igorlab/ph-leakage-tester/photos/README.md

# Photographs

Photographs of the tester, the amplifier boards and the test set-ups. All files are stored
without EXIF metadata (no GPS, camera model or date).

The photo figures of the paper (cropped, rotated and numbered) are made from these files by
`../figures/make_photo_figures.py`; the numbered parts are explained in the figure captions of
`../paper/HX_paper.md`.

| File | Content |
|---|---|
| `calibrator_outside.jpg` | The tester from outside, with the amplifier board in its holder |
| `calibrator_inside.jpg` | The tester without the display: ESP32-C3 SuperMini, ADS1115, 50 MΩ chain, push button, polarity switch, JP1, 10 kΩ trimmer, J2 and the BNC cable |
| `calibrator_inside_old.jpg` | Earlier internal layout (superseded by `calibrator_inside.jpg`) |
| `calibrator_50M.jpg` | The 50 MΩ series resistor: five 10 MΩ SMD resistors end to end, standing clear of the board |
| `calibrator_vs_ph150.jpg` | Channel A of the tester (−155.0 mV) next to a pH-150MI meter (−155 mV) on the same simulator, 25 °C |
| `board_input.jpg` | Amplifier board, input stage: pin 5 of U1 bent up and wired in the air to the BNC centre, solder links in place of the RA1/RA2 trimmers |
| `board_a_bottom.png` | Amplifier board A, underside, before the REF3040 rework |
| `board_a_ref3040_rework.png` | Board A after the rework: REF3040 on the R5 pads, 47 kΩ and the RA2 link |
| `board_ref3040.png` | REF3040 rework, close-up |
| `boards_three.jpg` | The tester with the amplifier board, a second amplifier board and a PH-4502C module |
| `setup.jpg`, `bench_webpage.jpg` | Bench set-up with the tester and its web page |
| `setup_electrode.jpg`, `setup_electrode_2.jpg` | Buffer test (protocol F): electrode in the 6.86 buffer, board on the tester, 4.00 and 9.18 buffers |
| `electrode_danoplus.jpg` | Box of the DANOPLUS electrode (pH 0–14, 0–60 °C) used as the reference electrode |
| `buffer_sachet.jpg` | Buffer sachet: 250 ml, ±0.01 pH, pH-versus-temperature table |
| `ph4502c_*.jpg` | PH-4502C module, both sides, chip markings |
