igorlab/ph-leakage-tester/figures/fig_known_currents.pdf

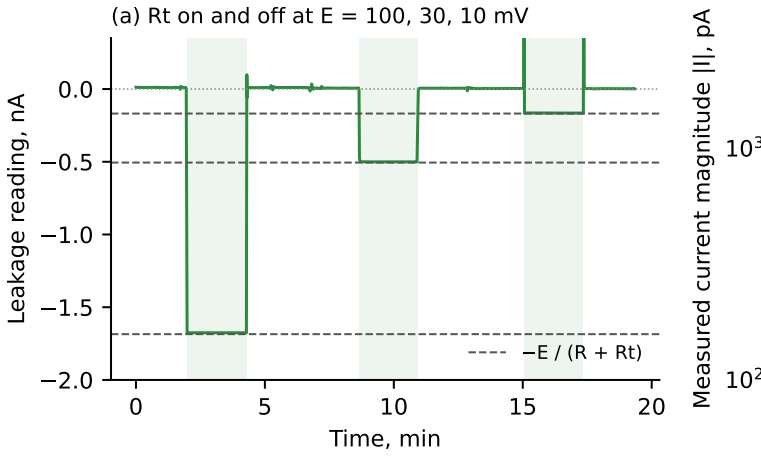
[picture p24: figure]
Time, min; Leakage reading, nA; (a) Rt on and off at E = 100, 30, 10 mV; Measured current magnitude |I|, pA

(b) Measured against expected

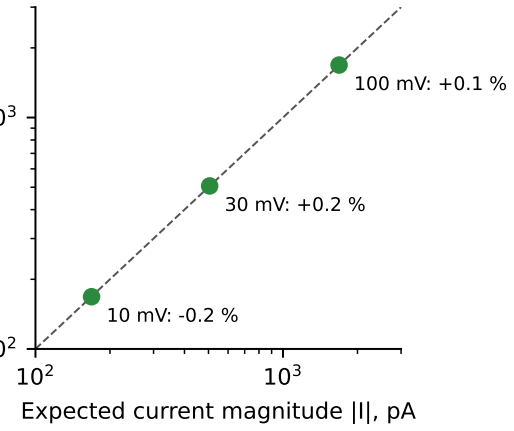
[picture p25: figure]
Expected current magnitude |I|, pA
