igorlab/ph-leakage-tester/figures/graphical_abstract.pdf

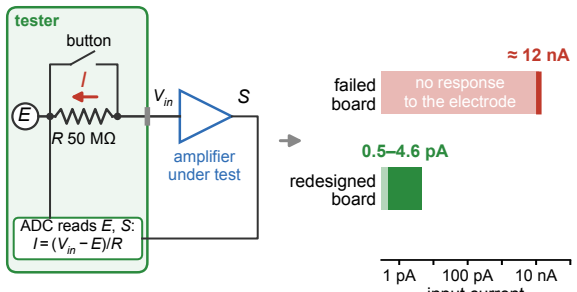
[picture p26: figure]
tester; button; Vin; amplifier under test; ADC reads E, S: I = (Vin; failed board; redesigned board; no response to the electrode
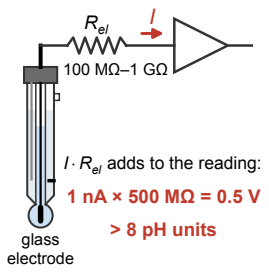
[picture p27: figure]
glass electrode; Rel; I ¢ Rel; adds to the reading:; > 8 pH units

input current

Problem | Tester (≈ EUR 15)

measures I in circuit, through the amplifier's own output

### Application: KH titrator

the redesigned board
runs in the titrator
