igorlab/ph-leakage-tester/figures/fig_principle.pdf

push button

# Button pressed (R shorted):

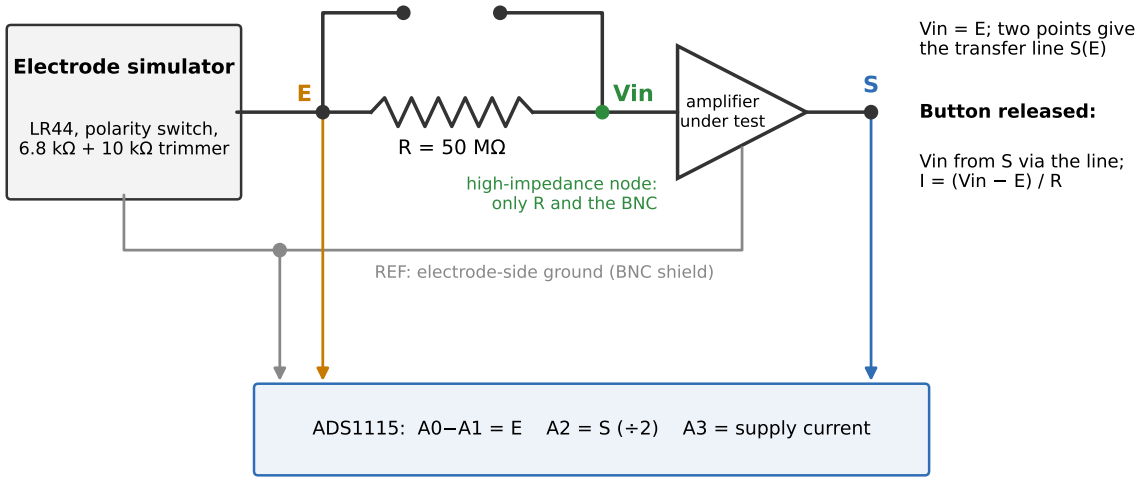
[picture p28: figure]
Electrode simulator; LR44, polarity switch,; k trimmer; Vin; high-impedance node: only R and the BNC; amplifier under test; REF: electrode-side ground (BNC shield); ADS1115: A0 A1 = E; A3 = supply current; Vin = E; two points give the transfer line S(E); Button released:; Vin from S via the line;; I = (Vin
