igorlab/ph-leakage-tester/figures/graphical_abstract.tif

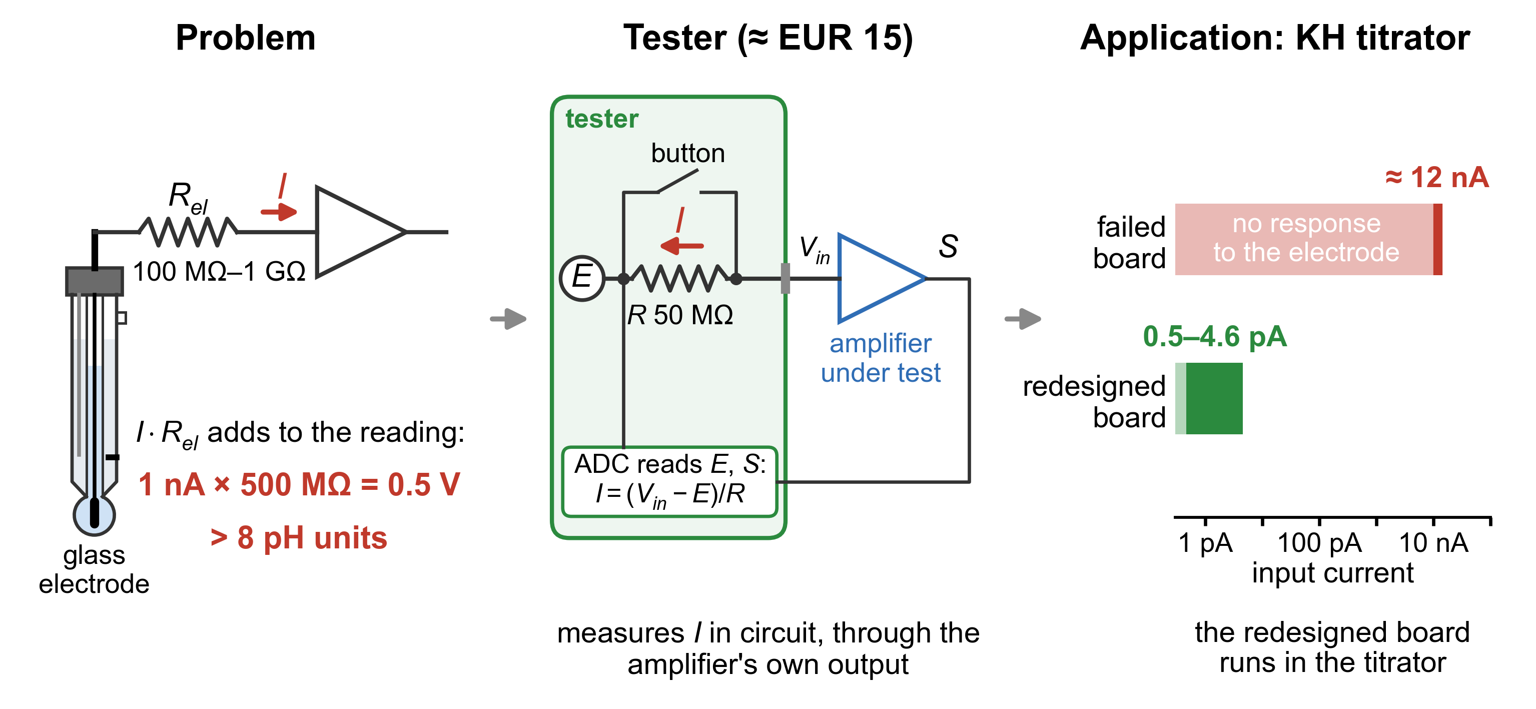
figures/graphical_abstract.tif
