igorlab/ph-leakage-tester/figures/photo_boards.jpg

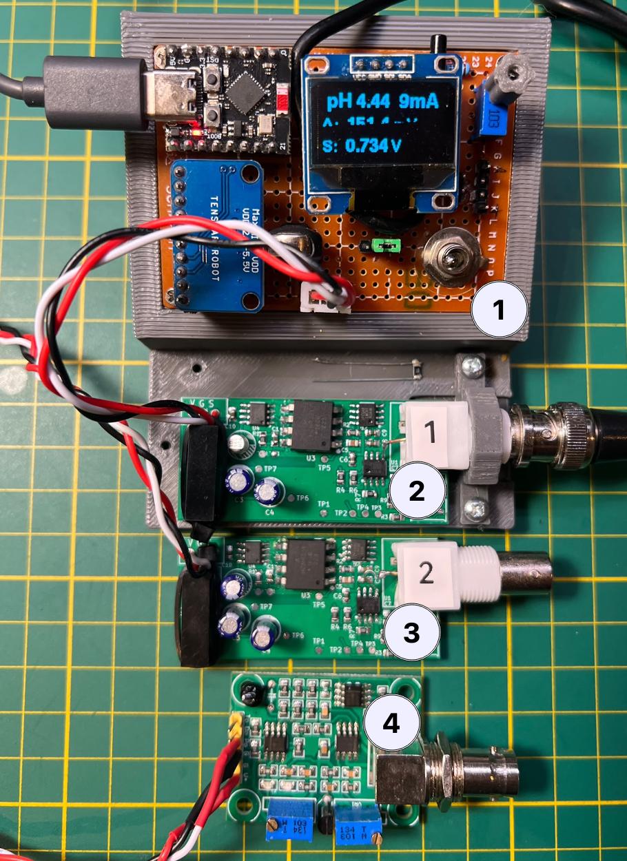
figures/photo_boards.jpg
