igorlab/ph-leakage-tester/figures/photo_channel_a.jpg

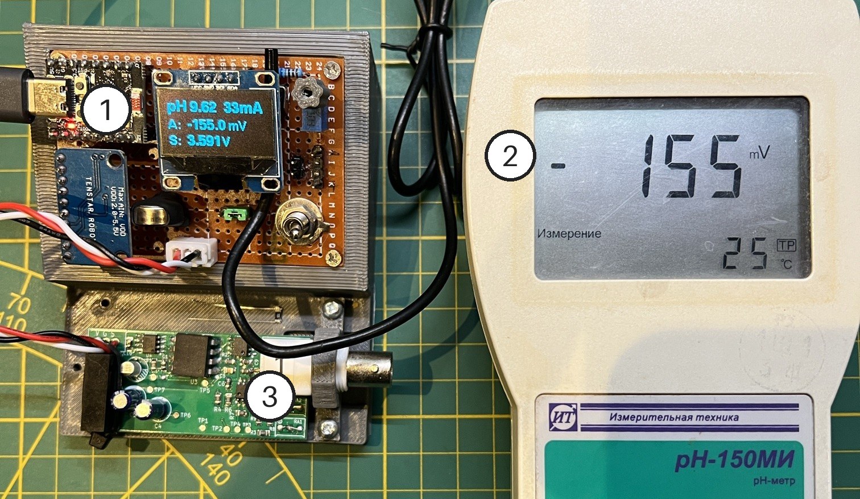
figures/photo_channel_a.jpg
