igorlab/ph-leakage-tester/figures/photo_r50m.jpg

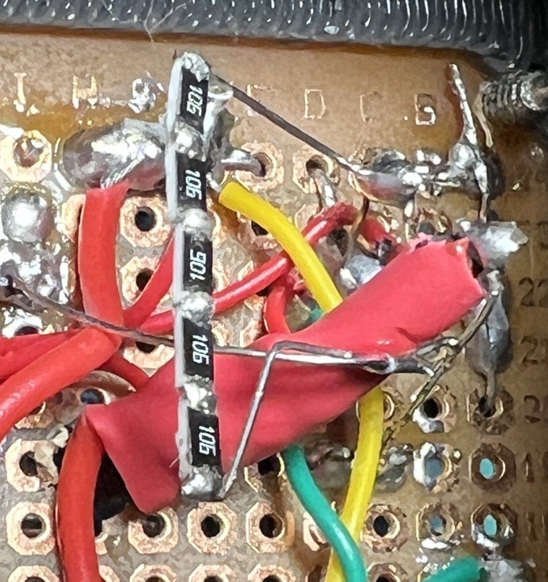
figures/photo_r50m.jpg
