igorlab/ph-leakage-tester/photos/bench_webpage.jpg

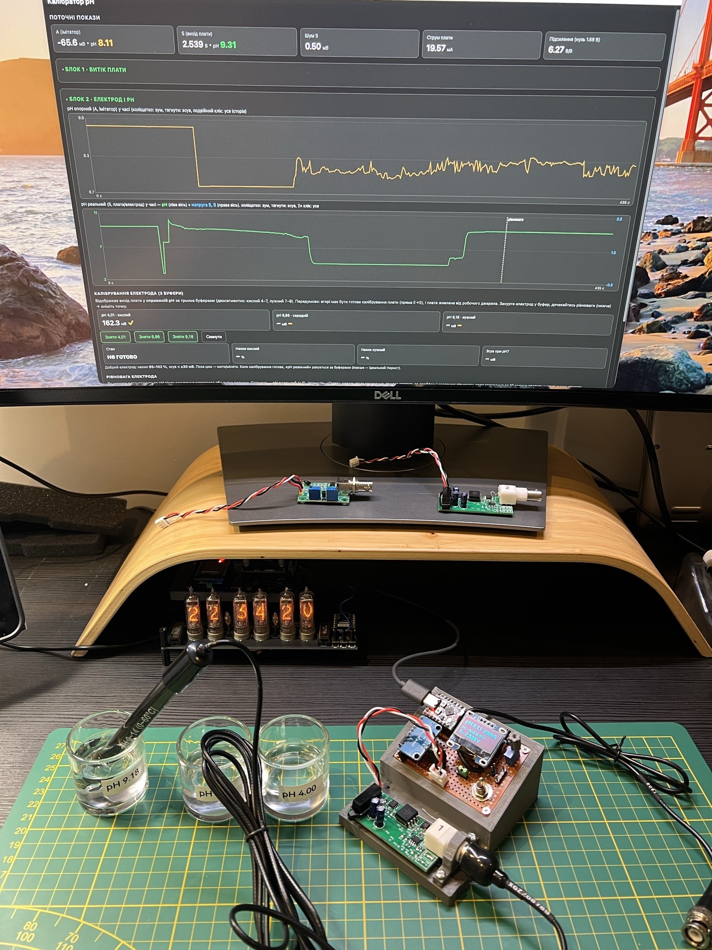
photos/bench_webpage.jpg
