igorlab/ph-leakage-tester/photos/board_a_bottom.png

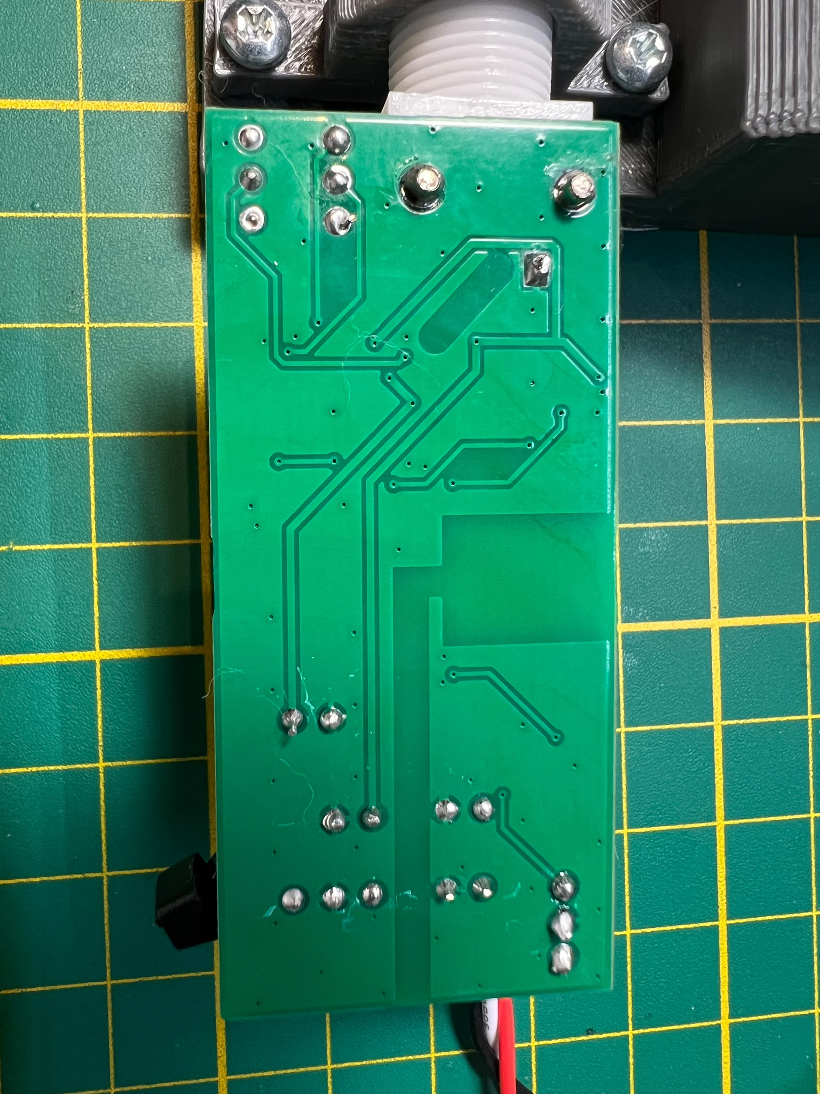
photos/board_a_bottom.png
