igorlab/ph-leakage-tester/photos/board_a_ref3040_rework.png

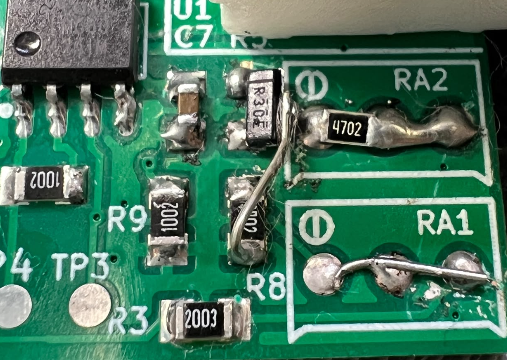
photos/board_a_ref3040_rework.png
