igorlab/ph-leakage-tester/photos/board_input.jpg

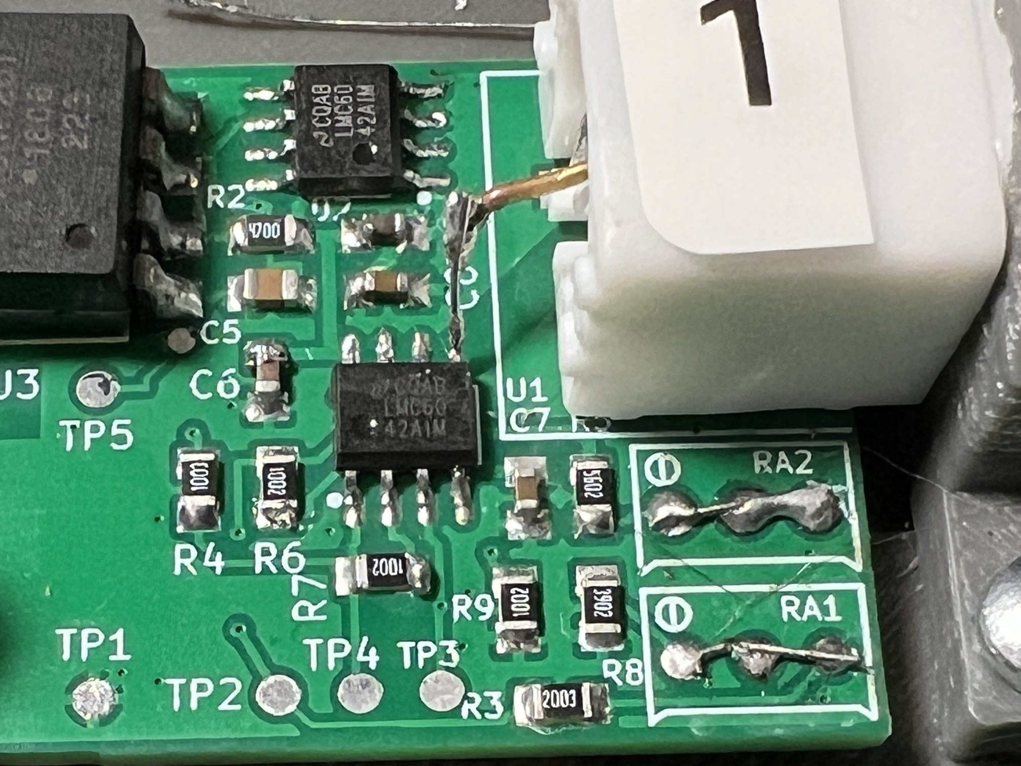
photos/board_input.jpg
