igorlab/ph-leakage-tester/photos/board_ref3040.png

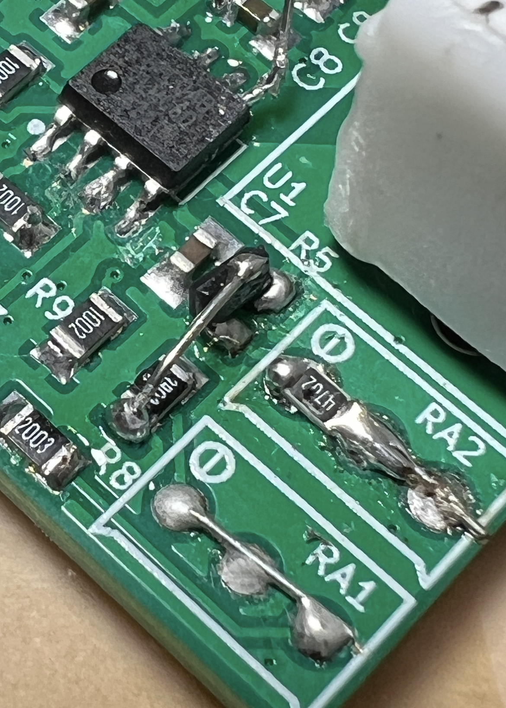
photos/board_ref3040.png
