igorlab/ph-leakage-tester/photos/boards_three.jpg

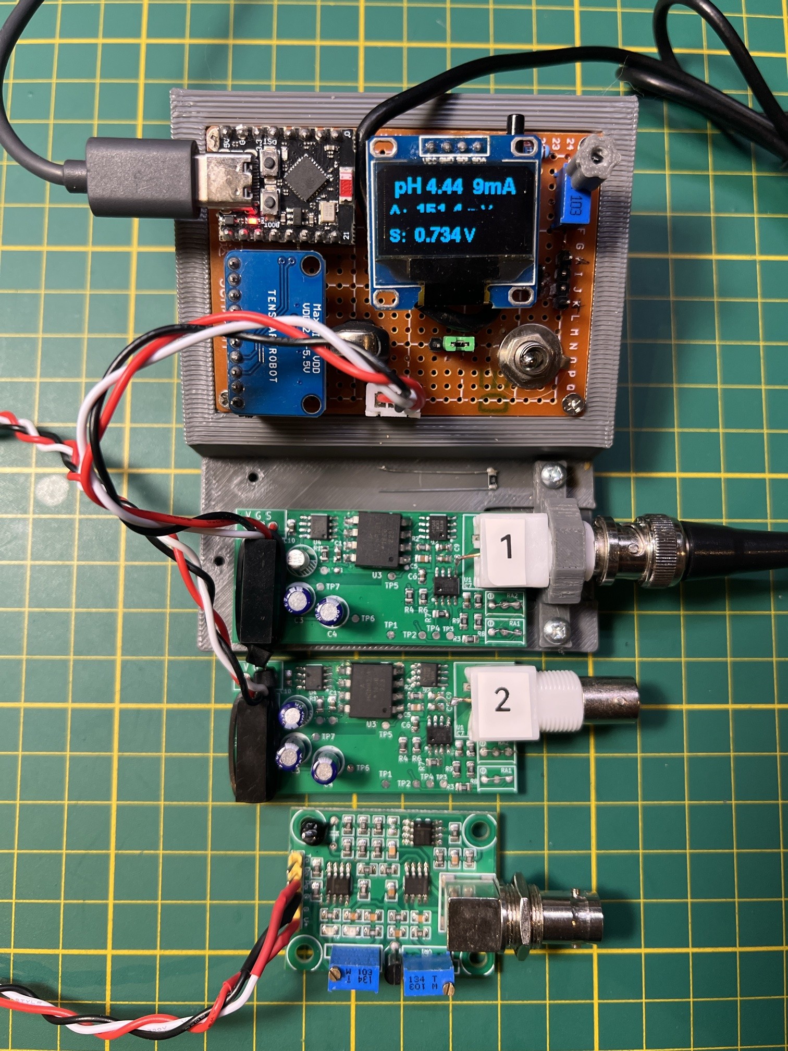
photos/boards_three.jpg
