igorlab/ph-leakage-tester/photos/buffer_sachet.jpg

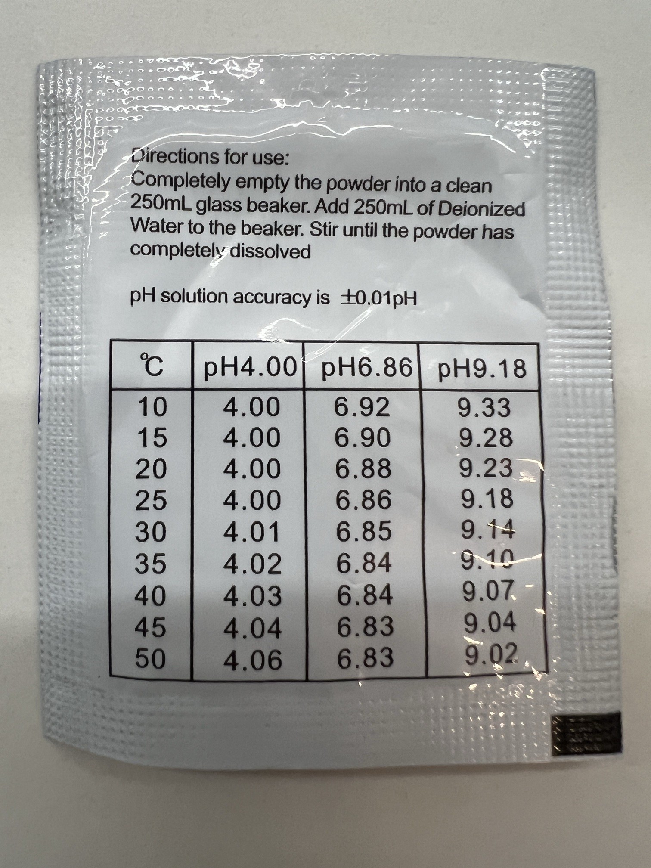
photos/buffer_sachet.jpg
