igorlab/ph-leakage-tester/photos/electrode_danoplus.jpg

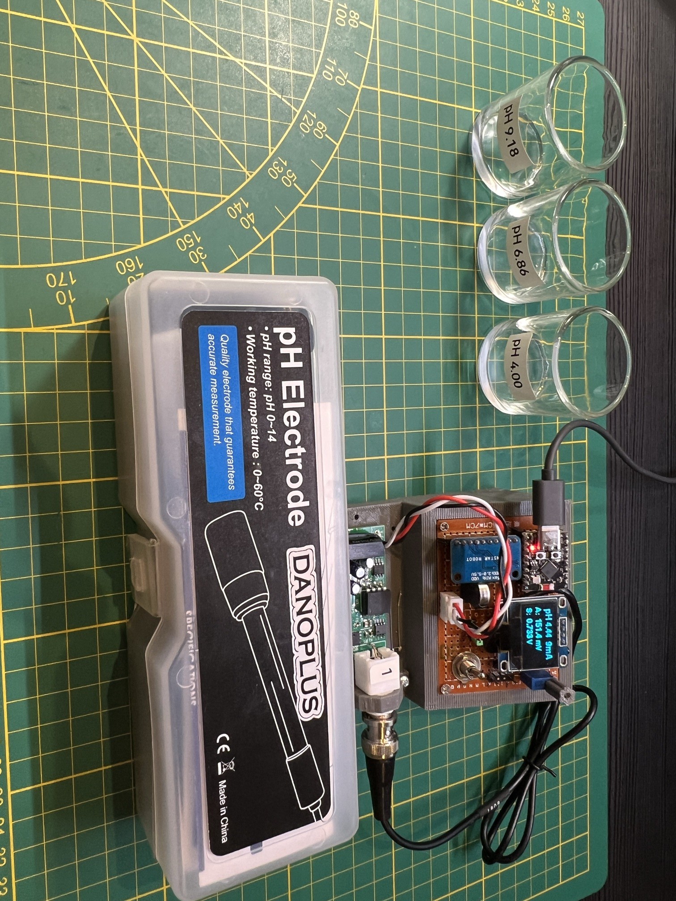
photos/electrode_danoplus.jpg
