igorlab/ph-leakage-tester/photos/ph4502c_back.jpg

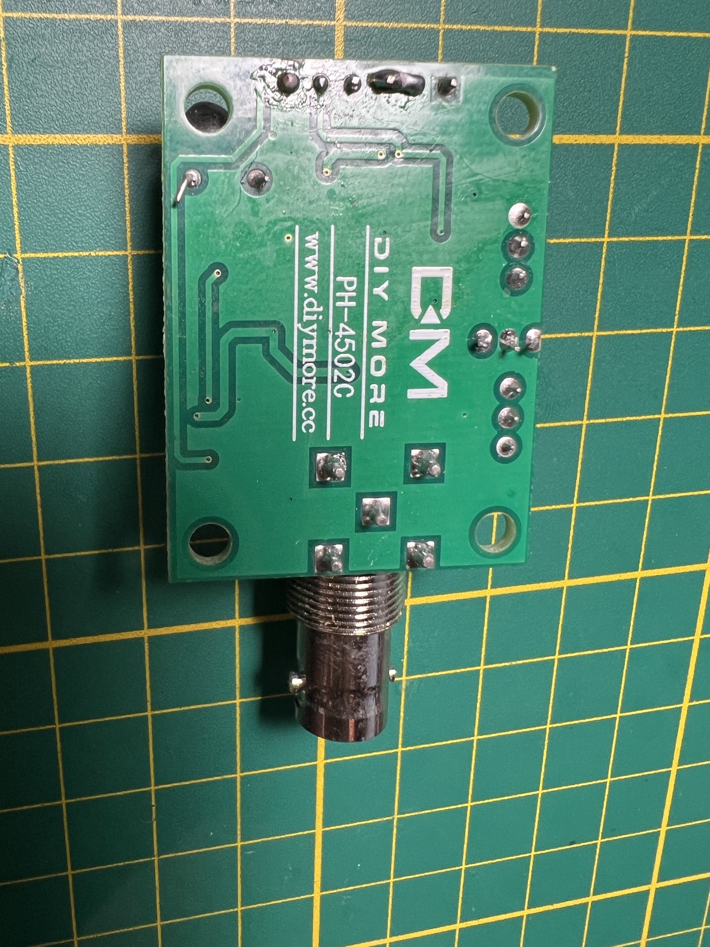
photos/ph4502c_back.jpg
