igorlab/ph-leakage-tester/photos/ph4502c_chips_1.jpg

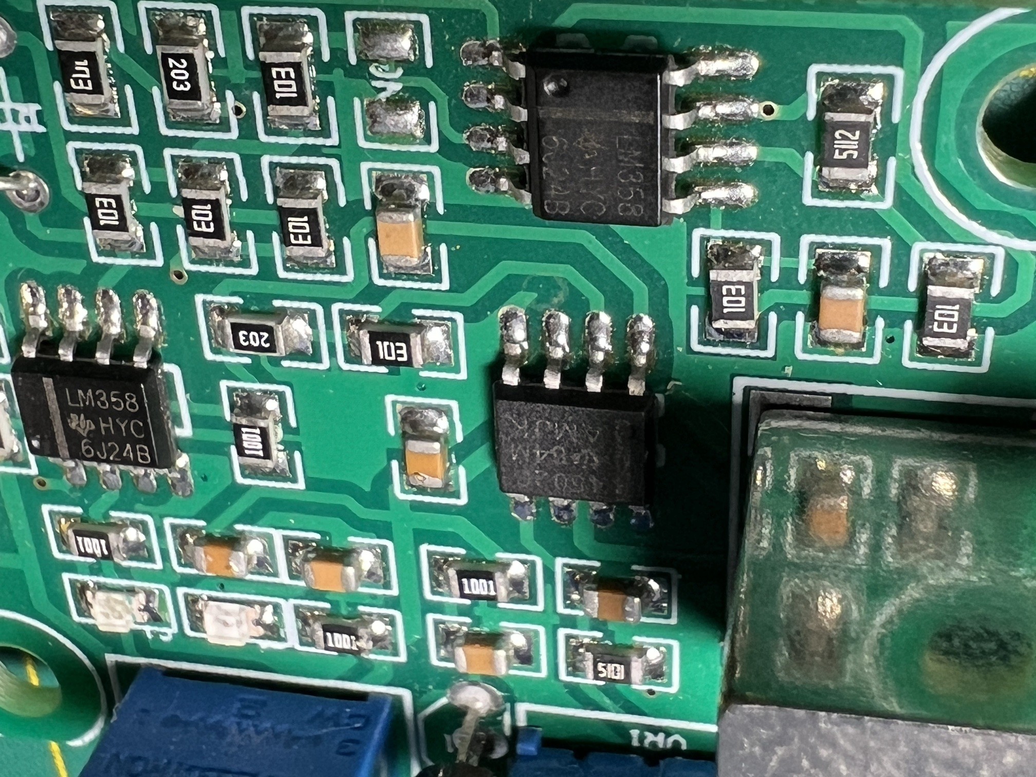
photos/ph4502c_chips_1.jpg
