igorlab/ph-leakage-tester/photos/ph4502c_chips_2.jpg

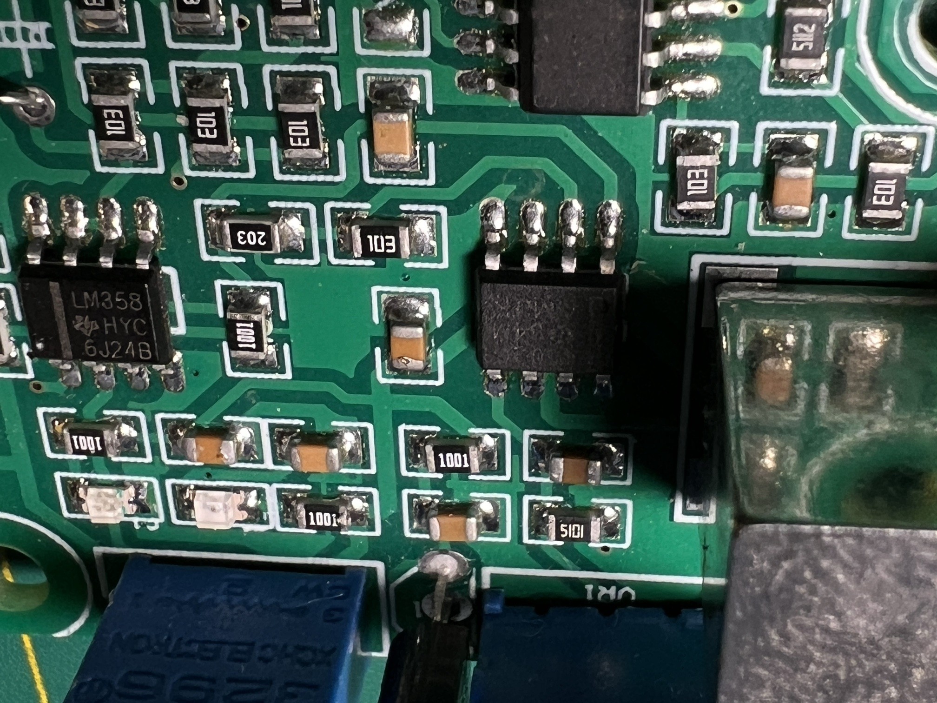
photos/ph4502c_chips_2.jpg
