igorlab/ph-leakage-tester/photos/ph4502c_chips_angle.jpg

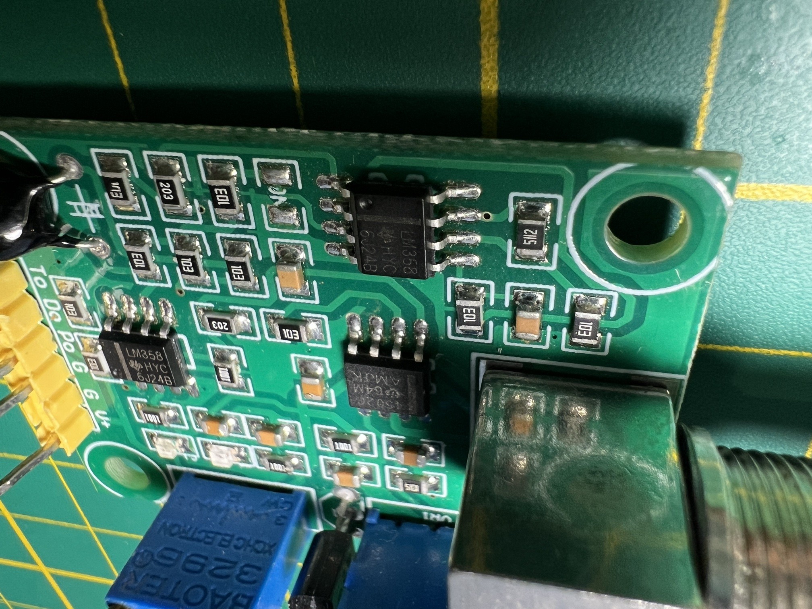
photos/ph4502c_chips_angle.jpg
