igorlab/ph-leakage-tester/photos/ph4502c_top.jpg

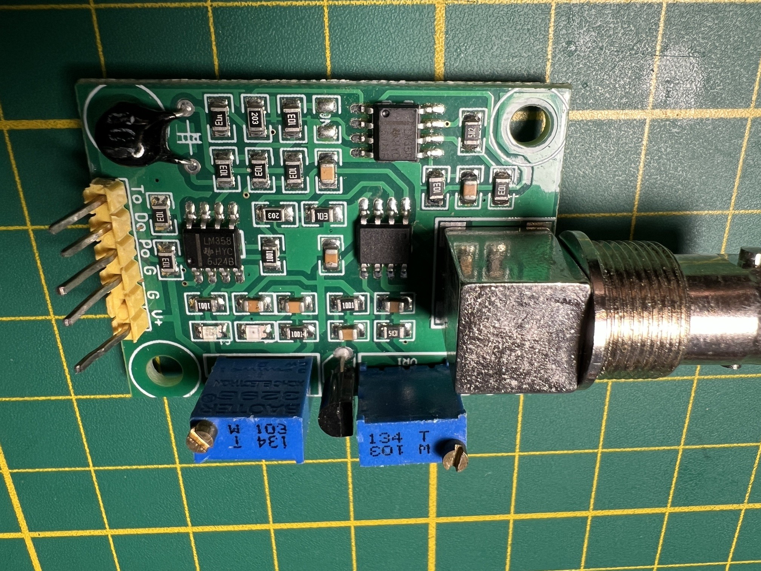
photos/ph4502c_top.jpg
