igorlab/ph-leakage-tester/hardware/calibrator_bom.xlsx

Battery-powered pH calibrator — bill of materials
Yellow cells require operator input. Electrical values and references are taken from hardware/calibrator.kicad_sch (revision 1).
Item | Subsystem | Reference | Quantity | Value | Description | Package / model | Manufacturer part | Supplier | Unit cost (EUR) | Notes / status
1 | Controller | U1 | 1 | ESP32-C3 SuperMini | Microcontroller module | ESP32-C3 SuperMini |  |  |  | Verify exact board version
2 | Measurement | U2 | 1 | ADS1115 module | 16-bit ADC module | ADS1115 breakout |  |  |  | Verify module manufacturer
3 | Display | U3 | 1 | SSD1306 OLED 128×64 | 0.96-inch I²C OLED module |  |  |  |  | Record pin order printed on module
4 | Simulator | BT1 | 1 | LR44 | Battery cell | LR44
5 | Simulator | — | 1 | LR44 holder | Battery holder |  |  |  |  | Not represented separately in schematic
6 | Simulator | SW1 | 1 | ON-OFF-ON | DPDT polarity-reversal switch |  |  |  |  | Centre-off
7 | Simulator | SW2 | 1 | Push button | Momentary button shorting the series resistor |  |  |  |  | Normally open
8 | Simulator | R1 | 1 | 6.8 kΩ | Resistor |  |  |  |  | Tolerance and power rating to confirm
9 | Simulator | RV1 | 1 | 10 kΩ | Trim potentiometer setting simulator voltage E
10 | High-impedance path | R2 | 5 | 10 MΩ | Series resistor chain; 50 MΩ total | 1206 |  |  |  | Five resistors soldered end to end
11 | Output | J1 | 1 | BNC female | Coaxial connector to amplifier input |  |  |  |  | Verify exact connector
12 | Amplifier interface | J2 | 1 | JST 3-pin | Supply, ground and S connection to amplifier |  |  |  |  | Verify JST series and pitch
13 | Amplifier supply | JP1 | 1 | 5 V / 3.3 V | Three-pin supply-selection jumper |  |  |  |  | Include shunt cap
14 | Output measurement | R3 | 1 | 10 kΩ | Resistor |  |  |  |  | Tolerance to confirm
15 | Output measurement | R4 | 1 | 10 kΩ | Resistor |  |  |  |  | Tolerance to confirm
16 | Current measurement | R5 | 1 | 10 Ω | Low-side current-sense shunt |  |  |  |  | Tolerance and power rating to confirm
17 | USB measurement | R6 | 1 | 10 kΩ | USB-voltage divider resistor |  |  |  |  | Orientation and ADC connection must match final schematic
18 | USB measurement | R7 | 1 | 15 kΩ | USB-voltage divider resistor |  |  |  |  | Orientation and ADC connection must match final schematic
19 | Test points | TP1 | 1 | REF | Reference-voltage test point | Pin / header
20 | Test points | TP2 | 1 | E | Simulator-voltage test point | Pin / header
21 | Test points | TP3 | 1 | VIN | Amplifier-input test point | Pin / header
22 | Construction | — | 1 | Perfboard | Main construction board |  |  |  |  | Enter board dimensions
23 | Construction | — |  | Hook-up wire | Point-to-point wiring |  |  |  |  | Enter length or package quantity
24 | Cable | — | 1 | Three-wire cable | Calibrator-to-amplifier cable |  |  |  |  | Record length and connector at amplifier end
25 | Mechanical | — | 1 | 3D-printed enclosure | Calibrator enclosure |  |  |  |  | Record material and print mass/time
26 | Mechanical | — |  | Fasteners and spacers | Mounting hardware |  |  |  |  | Enter quantities and sizes
 |  |  |  |  |  |  |  | Total (EUR) | €0.00
