igorlab/ph-leakage-tester/hardware/enclosure/pH-tester.STEP

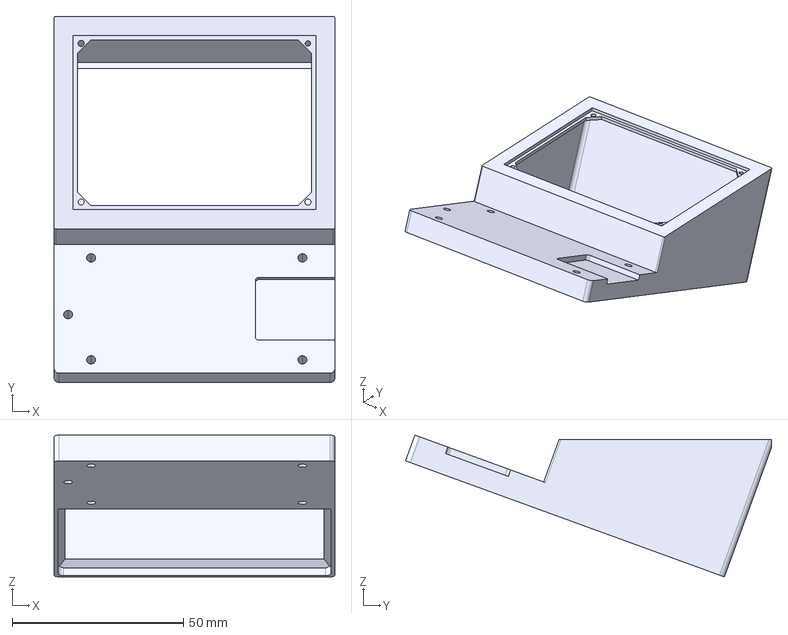
[picture p46: CAD file, 2026-11-10]
hardware/enclosure/pH-tester.STEP
82.0 x 106.8 x 41.4 mm
