igorlab/ph-leakage-tester/hardware/enclosure/board_holder.STEP

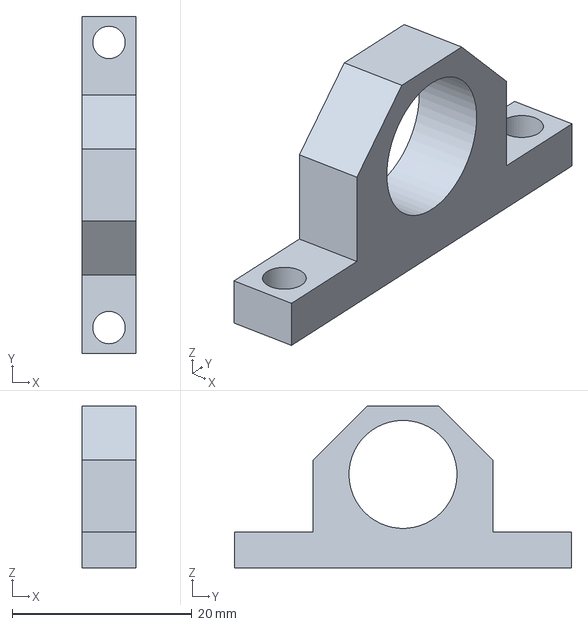
[picture p47: CAD file, 2026-11-10]
hardware/enclosure/board_holder.STEP
6.00 x 37.5 x 18.0 mm
