igorlab/ph-leakage-tester/(list of files, cad)

Other CAD files:
hardware/enclosure/board_holder.STL
hardware/enclosure/pH-tester.STL
