igorlab/ph-leakage-tester/figures/photo_setup_f.jpg

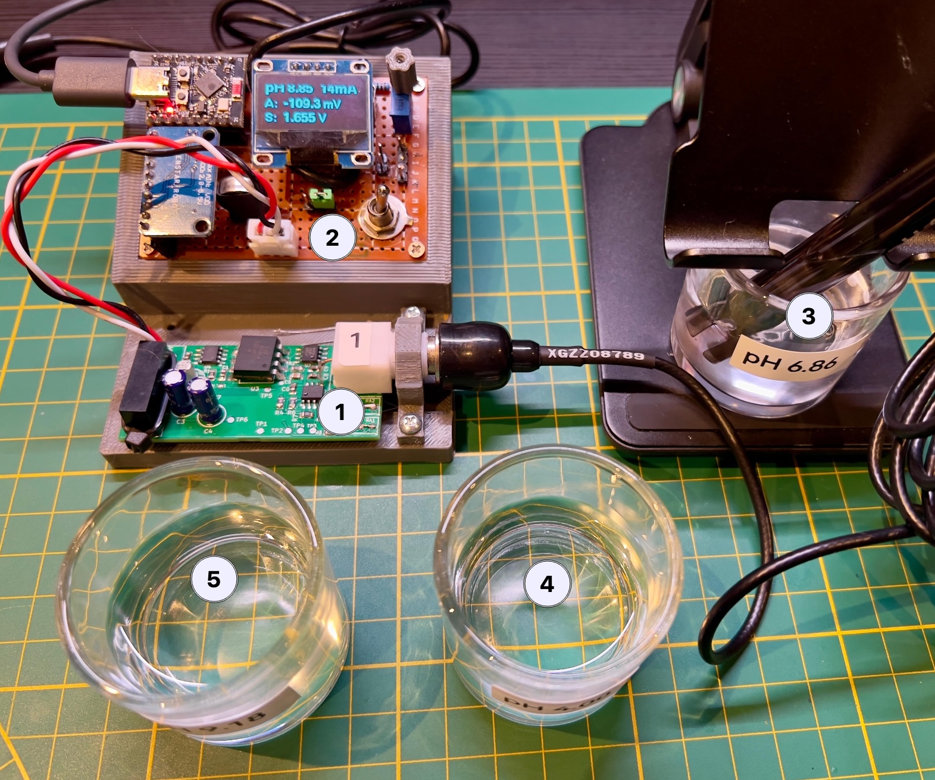
figures/photo_setup_f.jpg
