igorlab/ph-leakage-tester/photos/setup.jpg

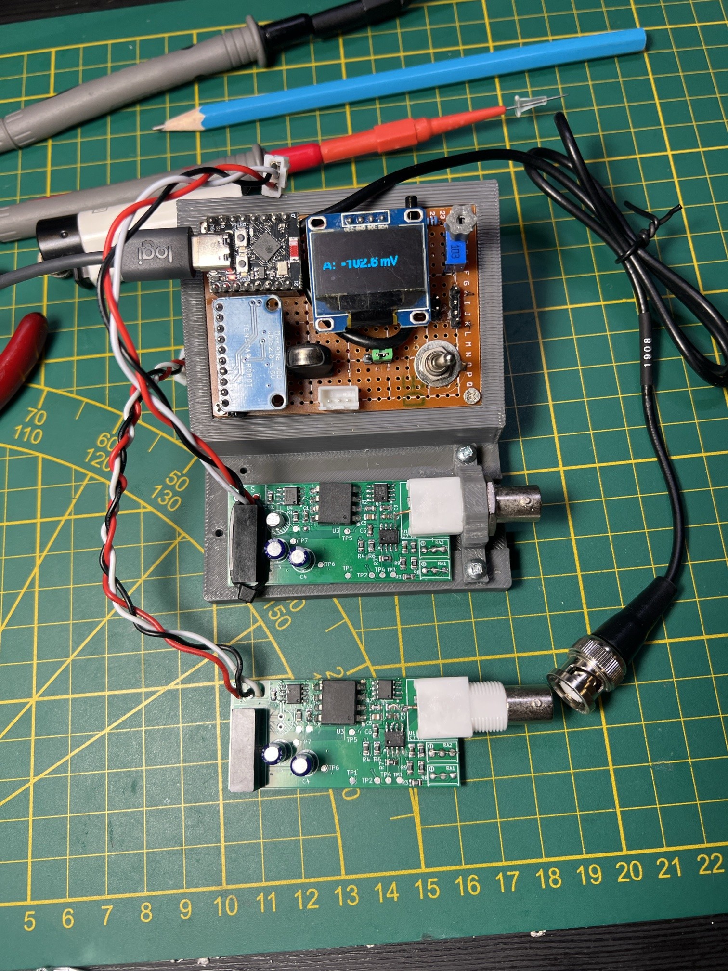
photos/setup.jpg
