igorlab/ph-leakage-tester/photos/setup_electrode.jpg

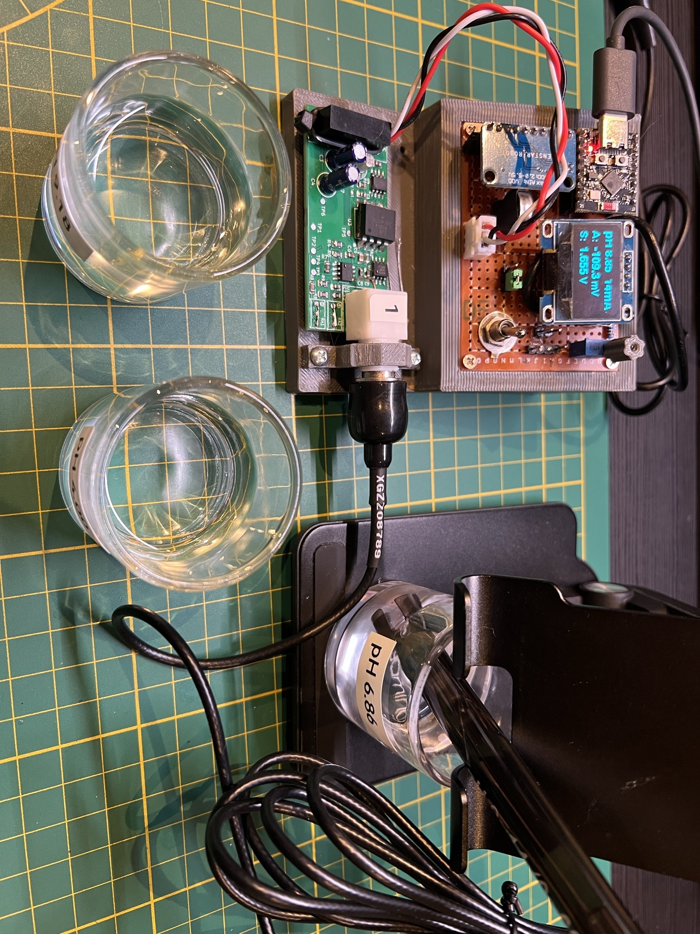
photos/setup_electrode.jpg
