igorlab/ph-leakage-tester/photos/setup_electrode_2.jpg

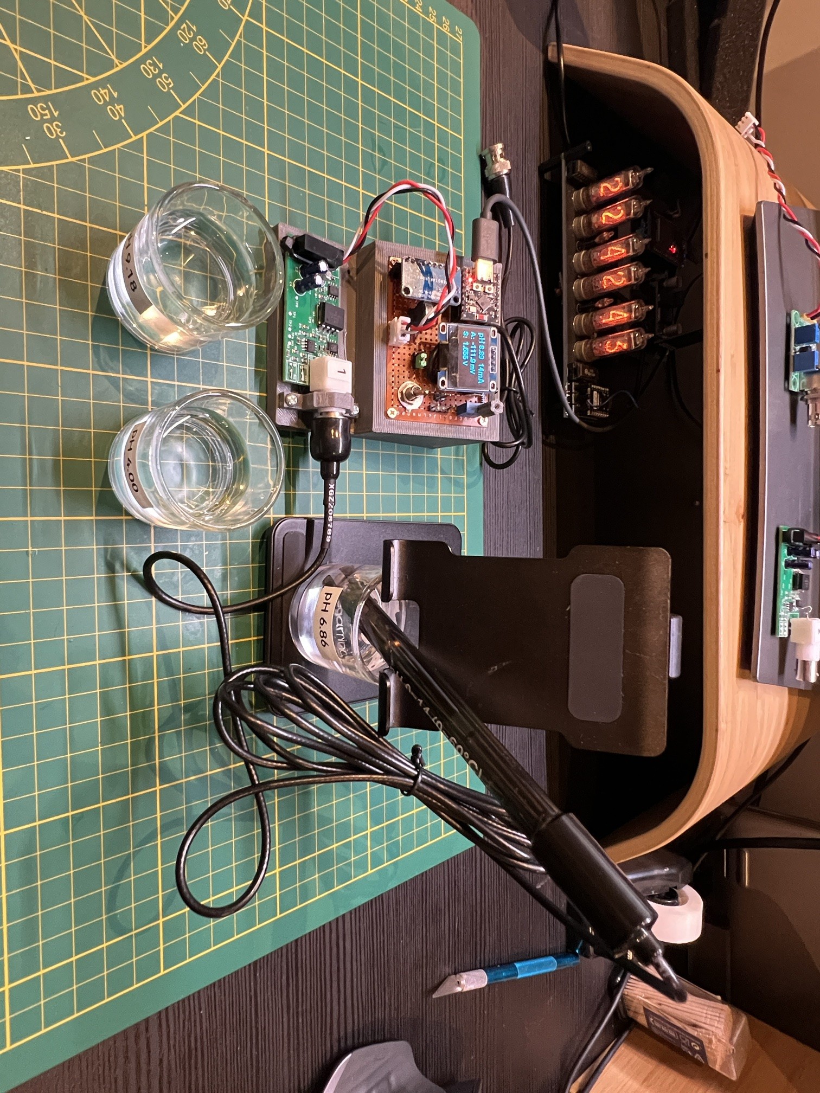
photos/setup_electrode_2.jpg
