igorlab/ph-leakage-tester/data/A_REF3040_bringup.csv

time | t_s | mark | e | s | ph | vin | il | noise | h1 | e1 | s1 | h2 | e2 | s2 | valid | gain | zero | r | norm | i | pr | pcv | psa | psb | pof | tc | usb | pc0 | pc1 | pc2 | bh0 | bv0 | bh1 | bv1 | bh2 | bv2
2026-10-25T21:06:08.244 | 0.08 | A_REF3040_bringup | 199.9 | 0.283 | 3.62 | 223.3 | 0.487 | 3.0 | 1 | 155.7 | 0.706 | 1 | -155.5 | 2.658 | 1 | -6.271 | 1.683 | 47.94 | 0.004 | 7.16 | 2.95 | 1 | 95.7 | 103.2 | -6.1 | 25.0 | 4.979 | 4.01 | 6.86 | 9.18 | 1 | 163.2 | 1 | 1.8 | 1 | -139.8
2026-10-25T21:06:08.693 | 0.53 | A_REF3040_bringup | 199.9 | 0.283 | 3.62 | 223.3 | 0.486 | 2.0 | 1 | 155.7 | 0.706 | 1 | -155.5 | 2.658 | 1 | -6.271 | 1.683 | 47.94 | 0.004 | 7.16 | 2.95 | 1 | 95.7 | 103.2 | -6.1 | 25.0 | 4.983 | 4.01 | 6.86 | 9.18 | 1 | 163.2 | 1 | 1.8 | 1 | -139.8
2026-10-25T21:06:09.188 | 1.02 | A_REF3040_bringup | 199.9 | 0.282 | 3.62 | 223.3 | 0.487 | 3.25 | 1 | 155.7 | 0.706 | 1 | -155.5 | 2.658 | 1 | -6.271 | 1.683 | 47.94 | 0.004 | 7.15 | 2.95 | 1 | 95.7 | 103.2 | -6.1 | 25.0 | 4.983 | 4.01 | 6.86 | 9.18 | 1 | 163.2 | 1 | 1.8 | 1 | -139.8
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
