igorlab/ph-leakage-tester/data/F_calibrator_browser_history_2026-10-26.csv

t_ms | pH_real_S | S_V | S_raw_V | shunt_drop_V | I_mA
1793029921267 | 6.850 | 1.4150 | 1.5550 | 0.1400 | 13.98
1793029922332 | 6.860 | 1.4170 | 1.5570 | 0.1400 | 14.00
1793029923475 | 6.860 | 1.4170 | 1.5570 | 0.1400 | 13.99
1793029924648 | 6.860 | 1.4180 | 1.5580 | 0.1400 | 14.00
1793029925826 | 6.860 | 1.4180 | 1.5580 | 0.1400 | 13.99
1793029927050 | 6.860 | 1.4180 | 1.5580 | 0.1400 | 14.00
1793029928180 | 6.860 | 1.4180 | 1.5590 | 0.1400 | 14.01
1793029929372 | 6.860 | 1.4190 | 1.5590 | 0.1400 | 14.00
1793029930539 | 6.870 | 1.4190 | 1.5590 | 0.1400 | 14.00
1793029931770 | 6.870 | 1.4200 | 1.5600 | 0.1400 | 14.00
1793029932894 | 6.870 | 1.4200 | 1.5600 | 0.1400 | 14.00
1793029934076 | 6.870 | 1.4200 | 1.5610 | 0.1400 | 14.01
1793029935256 | 6.870 | 1.4210 | 1.5610 | 0.1400 | 14.01
1793029936487 | 6.870 | 1.4210 | 1.5610 | 0.1400 | 14.01
1793029937611 | 6.860 | 1.4170 | 1.5570 | 0.1400 | 13.99
1793029938785 | 6.870 | 1.4210 | 1.5620 | 0.1400 | 14.03
1793029940029 | 6.880 | 1.4260 | 1.5670 | 0.1410 | 14.06
1793029941205 | 6.830 | 1.4080 | 1.5470 | 0.1390 | 13.95
1793029942326 | 6.860 | 1.4180 | 1.5580 | 0.1400 | 14.02
1793029943503 | 6.860 | 1.4180 | 1.5580 | 0.1400 | 14.02
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
