igorlab/ph-leakage-tester/data/test.csv

time | t_s | mark | e | s | ph | vin | il | noise | h1 | e1 | s1 | h2 | e2 | s2 | valid | gain | zero | r | norm | i
2026-10-22T17:00:39.560 | 0.14 |  | -147.7 | 2.687 | 9.5 | -159.0 | -0.568 | 1.0 | 1 | 149.6 | 0.752 | 1 | -150.1 | 2.631 | 1 | -6.268 | 1.69 | 20.0 | 0.004 | 20.65
2026-10-22T17:00:40.499 | 1.07 |  | -147.6 | 2.686 | 9.5 | -159.0 | -0.568 | 1.25 | 1 | 149.6 | 0.752 | 1 | -150.1 | 2.631 | 1 | -6.268 | 1.69 | 20.0 | 0.004 | 20.65
2026-10-22T17:00:41.485 | 2.06 |  | -147.7 | 2.686 | 9.5 | -159.0 | -0.567 | 1.25 | 1 | 149.6 | 0.752 | 1 | -150.1 | 2.631 | 1 | -6.268 | 1.69 | 20.0 | 0.004 | 20.64
2026-10-22T17:00:42.475 | 3.05 |  | -147.6 | 2.687 | 9.5 | -159.0 | -0.569 | 1.0 | 1 | 149.6 | 0.752 | 1 | -150.1 | 2.631 | 1 | -6.268 | 1.69 | 20.0 | 0.004 | 20.65
2026-10-22T17:00:43.567 | 4.14 |  | -147.7 | 2.686 | 9.5 | -159.0 | -0.566 | 1.25 | 1 | 149.6 | 0.752 | 1 | -150.1 | 2.631 | 1 | -6.268 | 1.69 | 20.0 | 0.004 | 20.65
2026-10-22T17:00:44.712 | 5.29 |  | -147.7 | 2.686 | 9.5 | -159.0 | -0.568 | 1.0 | 1 | 149.6 | 0.752 | 1 | -150.1 | 2.631 | 1 | -6.268 | 1.69 | 20.0 | 0.004 | 20.65
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
