igorlab/ph-leakage-tester/figures/photo_calibrator_inside.jpg

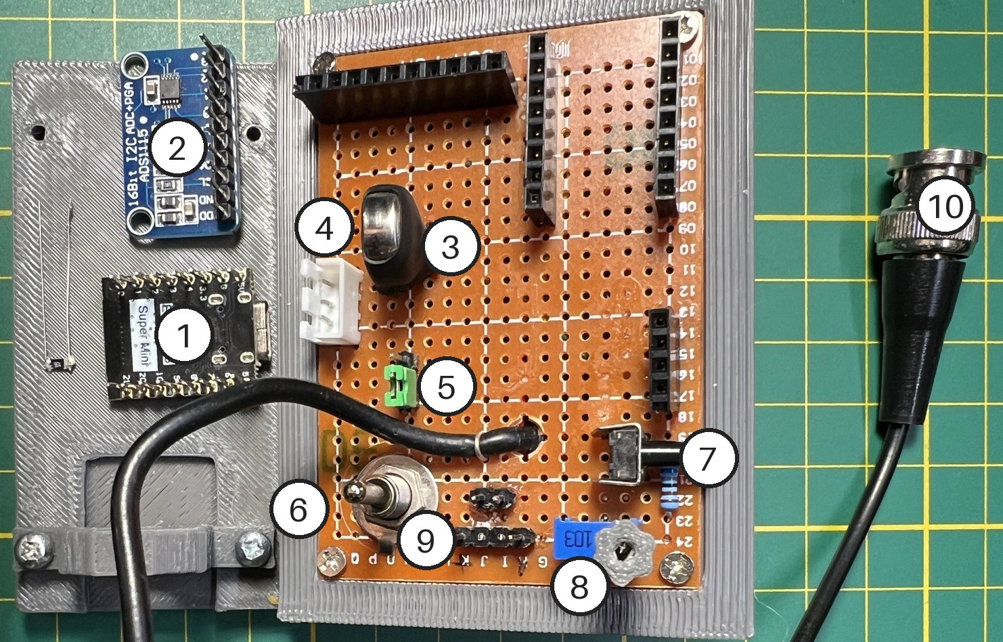
figures/photo_calibrator_inside.jpg
