igorlab/ph-leakage-tester/photos/calibrator_50M.jpg

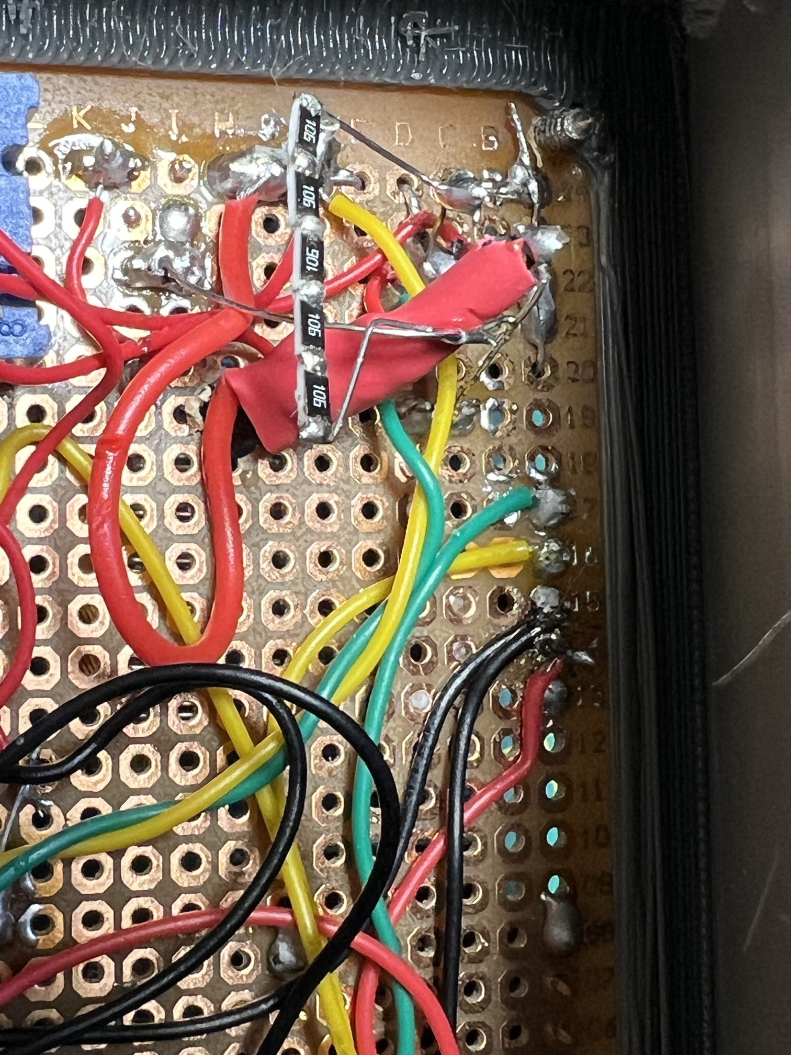
photos/calibrator_50M.jpg
