igorlab/ph-leakage-tester/photos/calibrator_inside.jpg

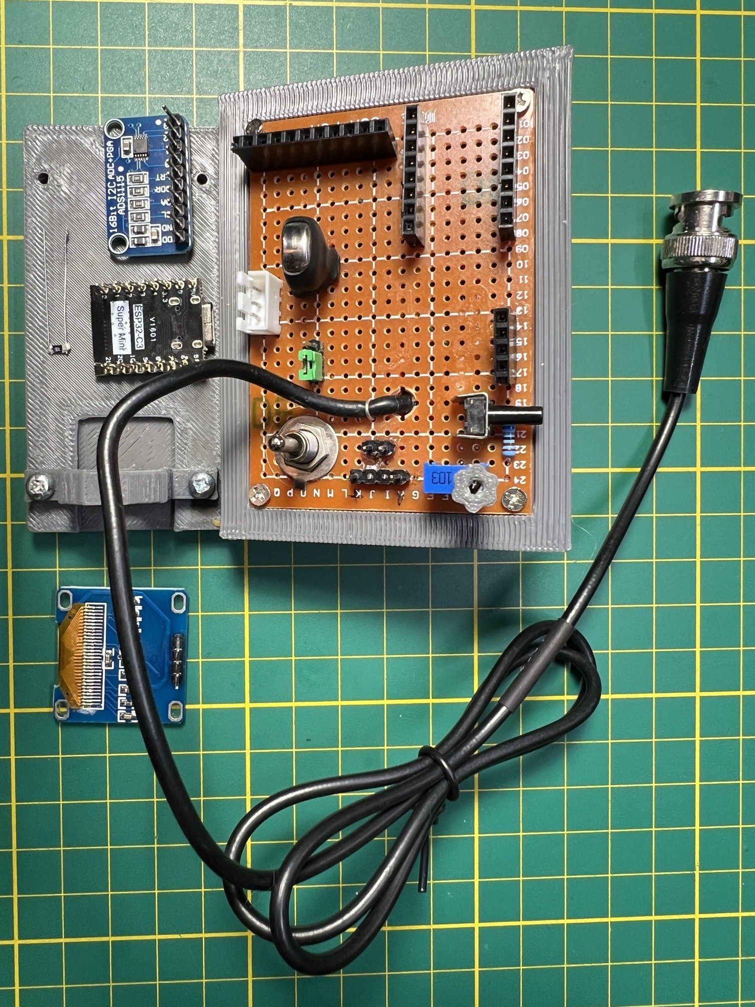
photos/calibrator_inside.jpg
