igorlab/ph-leakage-tester/photos/calibrator_outside.jpg

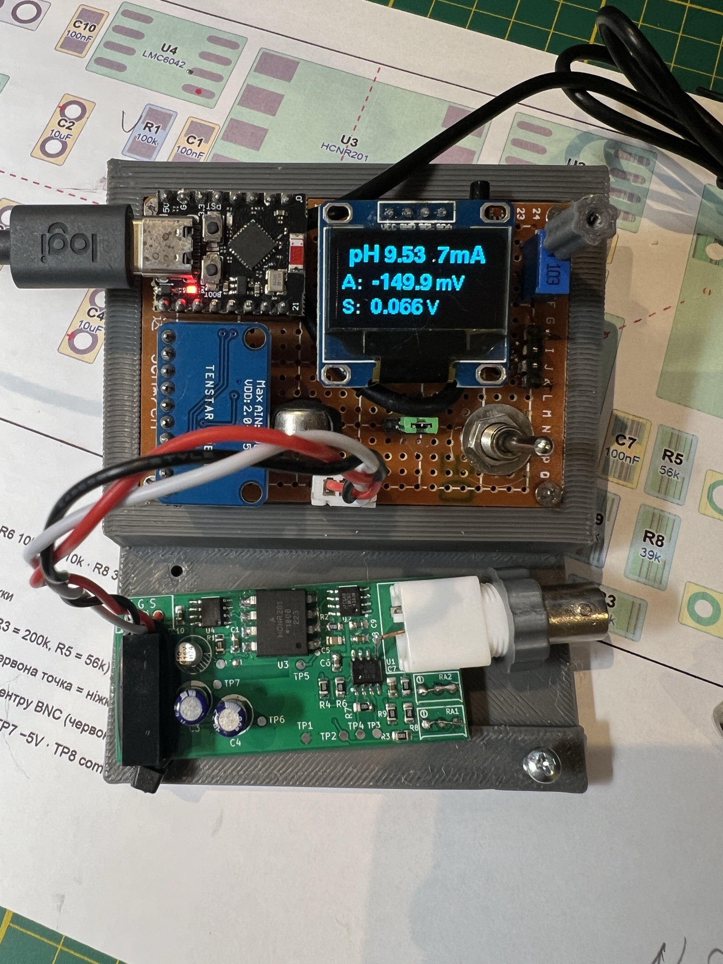
photos/calibrator_outside.jpg
