igorlab/ph-leakage-tester/photos/calibrator_vs_ph150.jpg

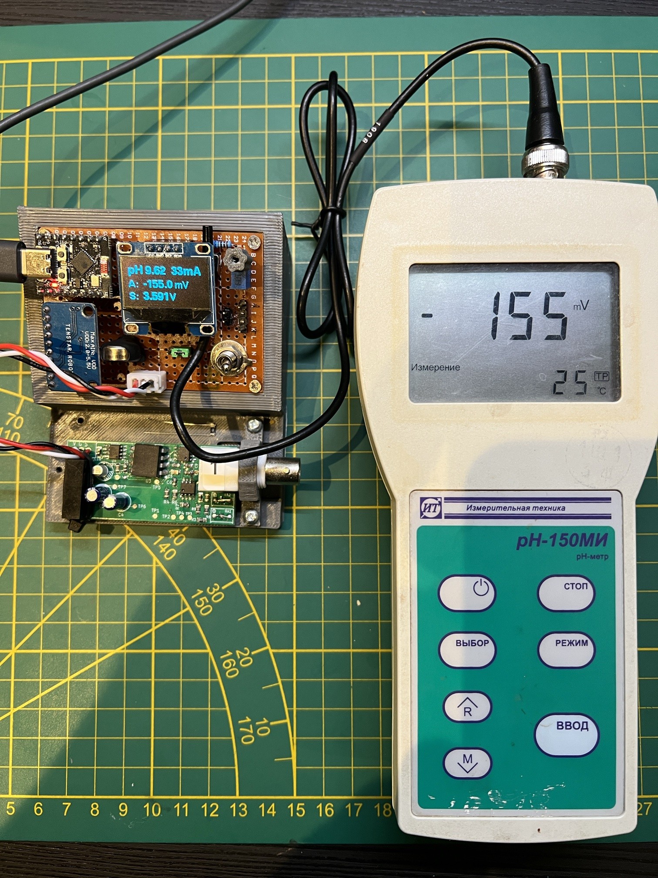
photos/calibrator_vs_ph150.jpg
