igorlab/ph-leakage-tester/figures/fig_calibrator_schematic.pdf

## ESP32-C3 SuperMini

### SSD1306

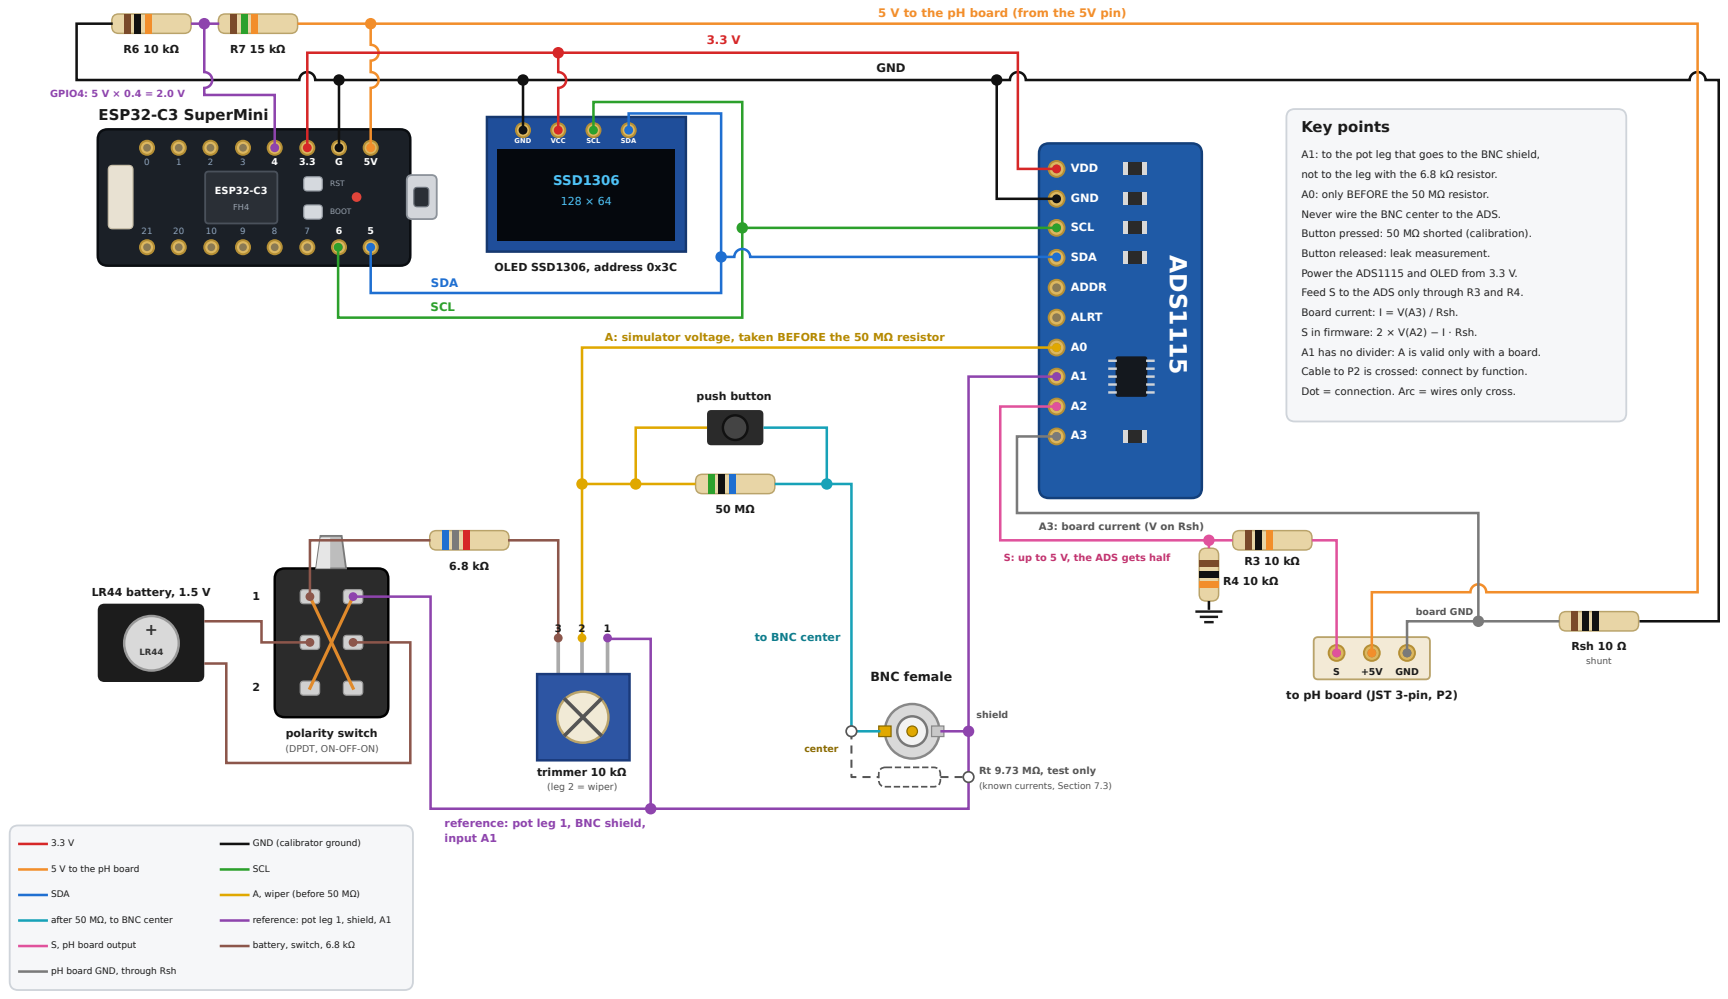
[picture p57: page 1]
GND; GPIO4: 5 V × 0.4 = 2.0 V; SDA; SCL; board GND; Rsh 10 Ω; shunt; ESP32-C3; RST; BOOT; VCC; OLED SSD1306, address 0x3C; VDD; ADDR; ALRT; ADS1115; push button; trimmer 10 kΩ (leg 2 = wiper); BNC female; center; shield; LR44 battery, 1.5 V; S +5V GND; Key points

5 V to the pH board (from the 5V pin)

A1: to the pot leg that goes to the BNC shield,
not to the leg with the 6.8 kΩ resistor.
A0: only BEFORE the 50 MΩ resistor.
Never wire the BNC center to the ADS.
Button pressed: 50 MΩ shorted (calibration).
Button released: leak measurement.
Power the ADS1115 and OLED from 3.3 V.
Feed S to the ADS only through R3 and R4.
Board current: I = V(A3) / Rsh.
S in firmware: 2 × V(A2) − I · Rsh.
A1 has no divider: A is valid only with a board.
Cable to P2 is crossed: connect by function.
Dot = connection. Arc = wires only cross.

A: simulator voltage, taken BEFORE the 50 MΩ resistor

A3: board current (V on Rsh)

S: up to 5 V, the ADS gets half

to BNC center

to pH board (JST 3-pin, P2)

polarity switch
(DPDT, ON-OFF-ON)

Rt 9.73 MΩ, test only
(known currents, Section 7.3)

reference: pot leg 1, BNC shield,
input A1

GND (calibrator ground)

5 V to the pH board

A, wiper (before 50 MΩ)

after 50 MΩ, to BNC center

reference: pot leg 1, shield, A1

S, pH board output

battery, switch, 6.8 kΩ

pH board GND, through Rsh
