igorlab/ph-leakage-tester/ph_board/docs/ph_board_schematic.pdf

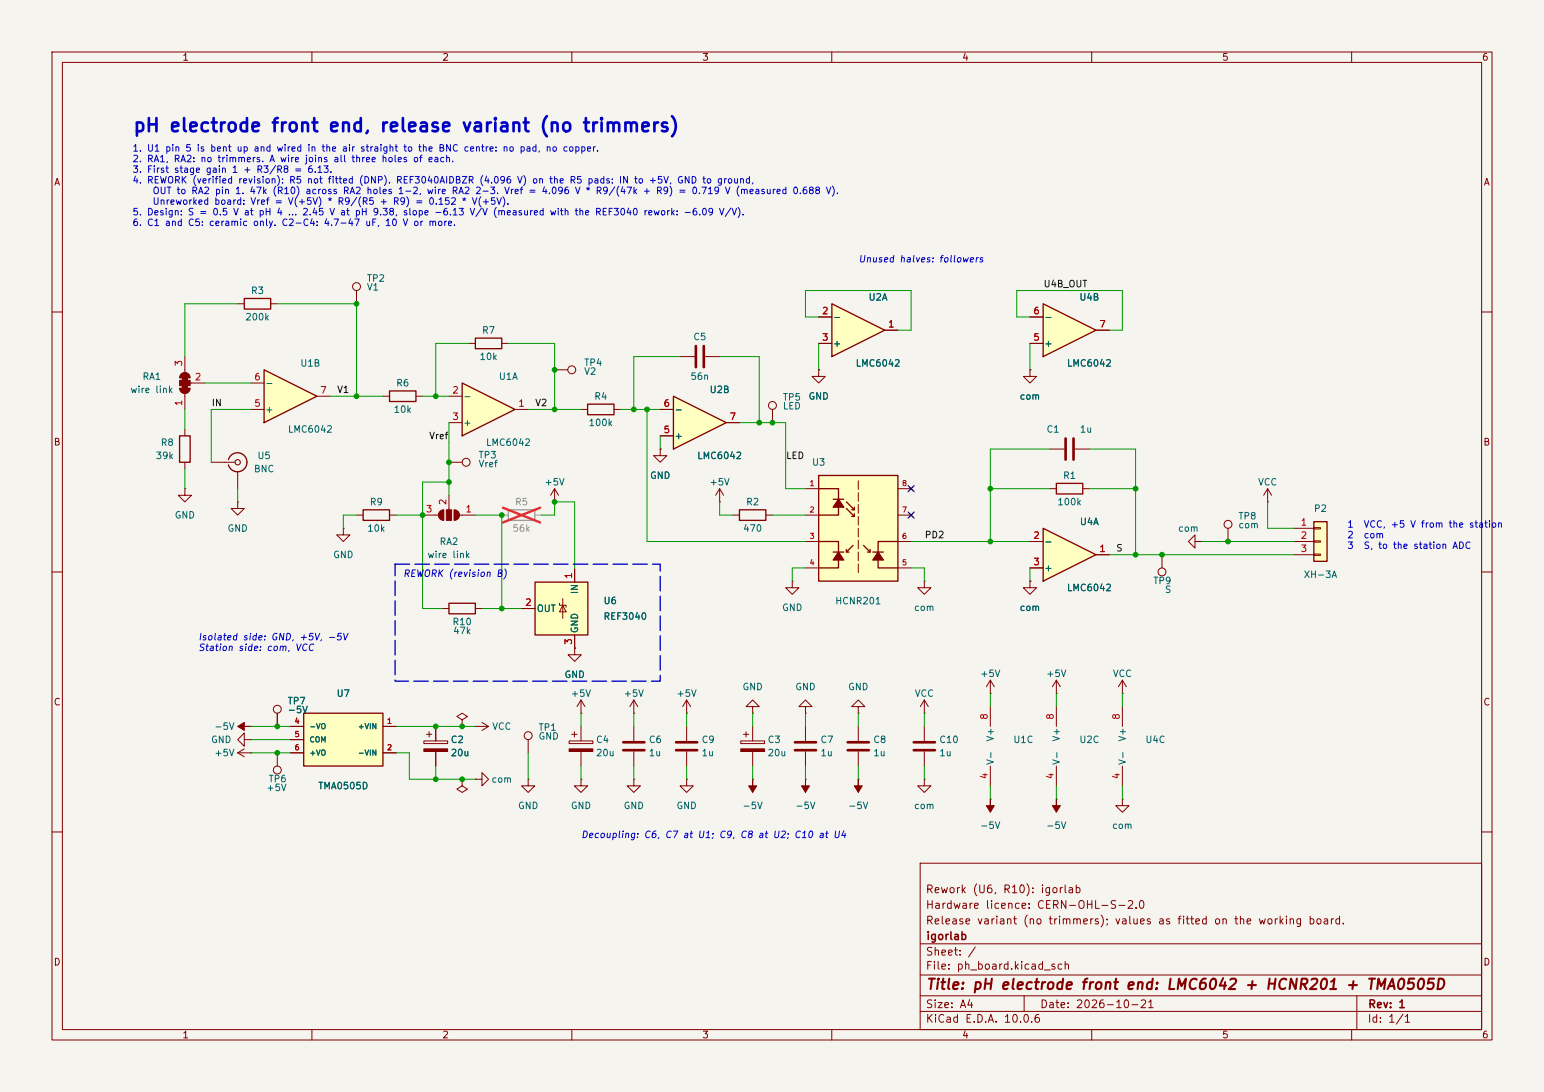
[picture p58: page 1]

Isolated side: GND, +5V, -5V Station side: com, VCC pH electrode front end, release variant (no trimmers)

3 S, to the station ADC

Decoupling: C6, C7 at U1; C9, C8 at U2; C10 at U4

Rework (U6, R10): igorlab
Hardware licence: CERN-OHL-S-2.0
Release variant (no trimmers); values as fitted on the working board.
igorlab
Sheet: /
File: ph_board.kicad_sch
Title: pH electrode front end: LMC6042 + HCNR201 + TMA0505D

Size: A4 | Rev: 1
KiCad E.D.A. 10.0.6 | Id: 1/1
