igorlab/ph-leakage-tester/figures/fig_leak_error.pdf

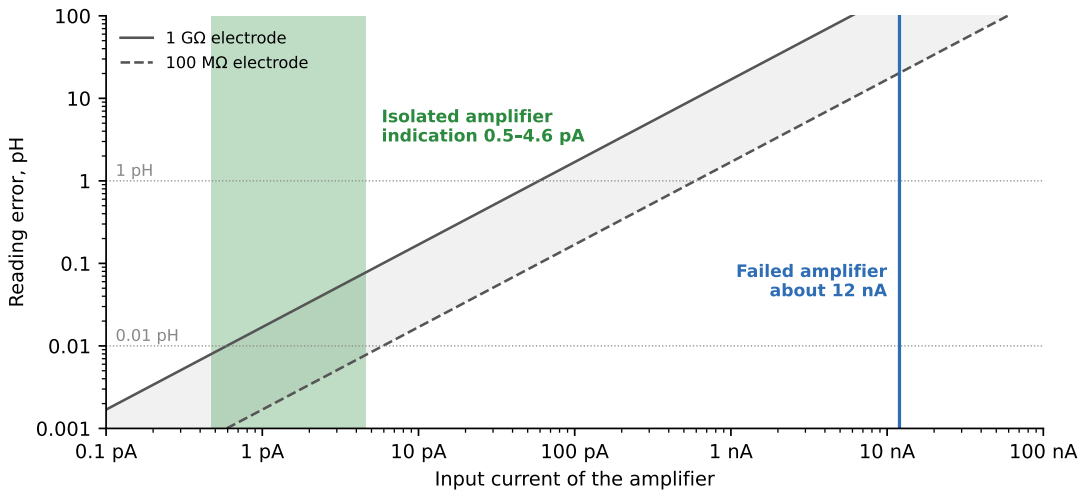
[picture p59: page 1]
Failed amplifier about 12 nA; Isolated amplifier indication 0.5 4.6 pA; electrode; 100 M electrode

Reading error, pH

Input current of the amplifier
