igorlab/ph-leakage-tester/figures/fig_supply_sensitivity.pdf

60

80

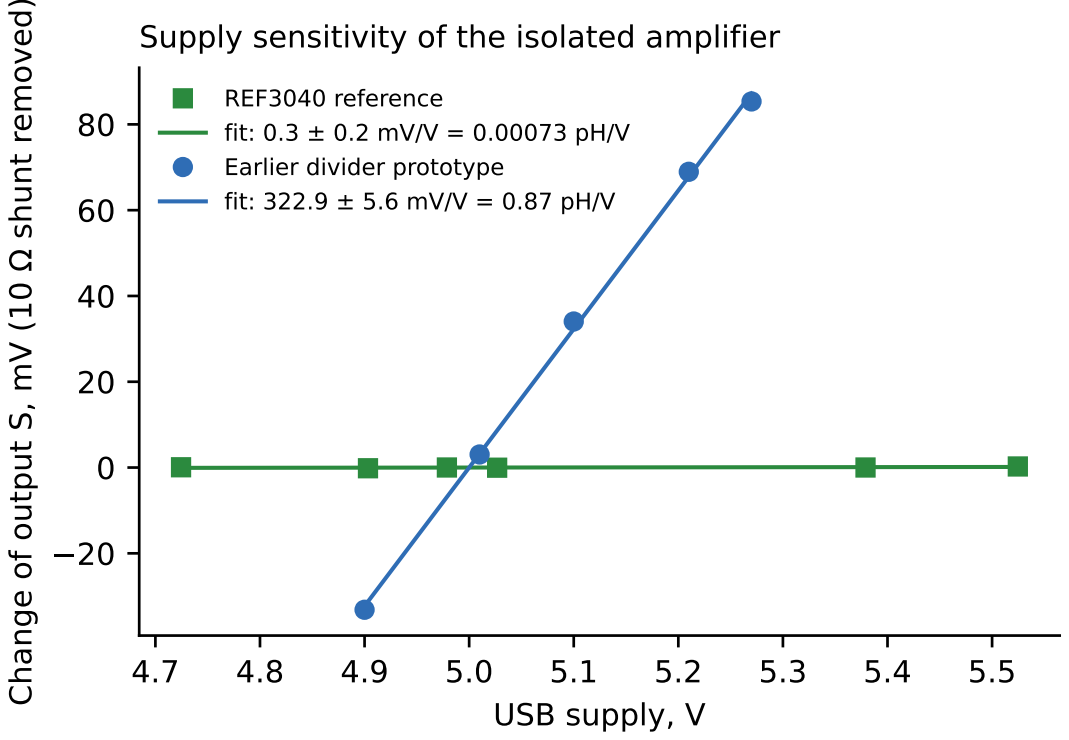
[picture p60: page 1]
USB supply, V

Change of output S, mV (10 shunt removed)

Supply sensitivity of the isolated amplifier

REF3040 reference
fit: 0.3 ± 0.2 mV/V = 0.00073 pH/V
Earlier divider prototype
fit: 322.9 ± 5.6 mV/V = 0.87 pH/V
