igorlab/ph-leakage-tester/figures/fig_kh_history.pdf

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

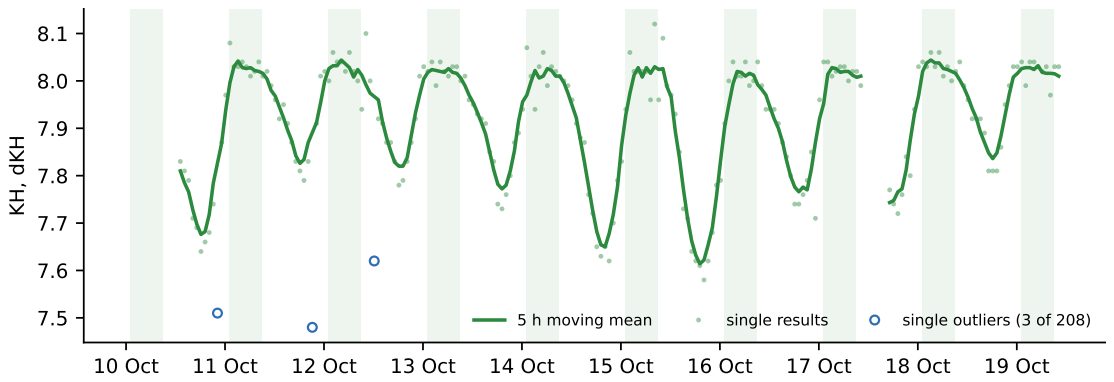
[picture p61: page 1]
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
