igorlab/ph-leakage-tester/ph_board/kicad_manufactured/ph_board.kicad_pcb

## KiCad design ph_board/kicad_manufactured/ph_board.kicad_pcb (2026-10-29)

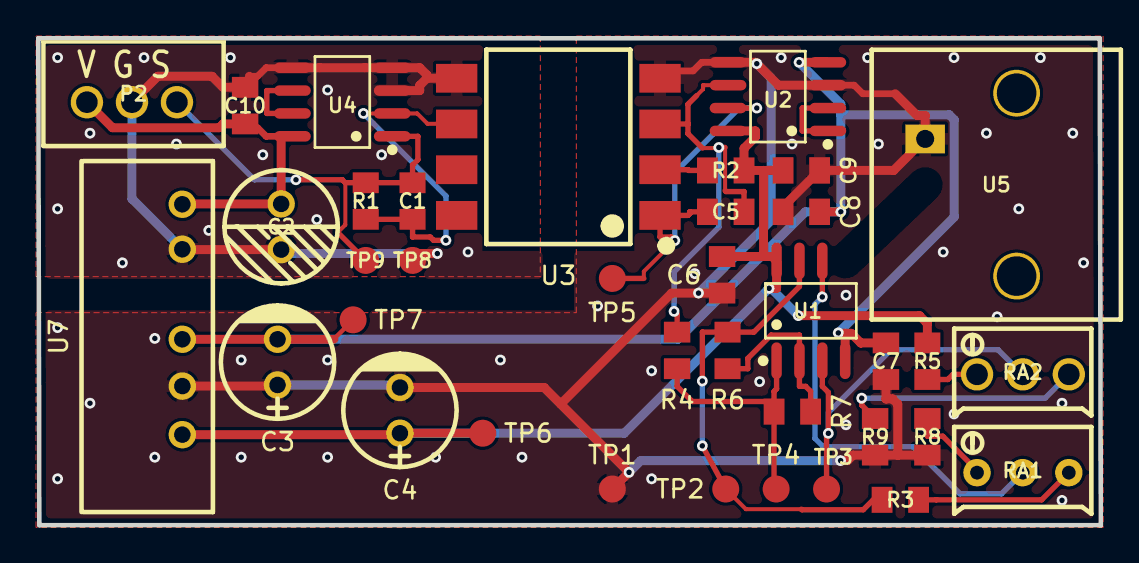
[picture p66: board ph_board.kicad_pcb from above]

Board: 2 copper layers, 59.0 x 27.1 mm, 37 parts (0 on the bottom side), 21 nets.

Parts:
C1, C5, C6, C7, C8, C9, C10: 100nF; 0805
C2: 10uF; CAP-GT-6.3*7
C3, C4: 10uF; CAP-D6.3XF2.5
P2: XH-3A
R1, R4: 100k; 0805
R2: 470; 0805
R3: 220k; 0805
R5: 82k; 0805
R6, R7, R9: 10k; 0805
R8: 39k; 0805
RA1, RA2: 10k; RES-ADJ_3296W
TP1: GND; Test-Point-0.5mm
TP2: V1; Test-Point-0.5mm
TP3: Vref; Test-Point-0.5mm
TP4: V2; Test-Point-0.5mm
TP5: LED; Test-Point-0.5mm
TP6: +5V; Test-Point-0.5mm
TP7: -5V; Test-Point-0.5mm
TP8: com; Test-Point-0.5mm
TP9: S; Test-Point-0.5mm
U1, U2, U4: LMC6042; SOIC-8_L4.9-W3.8-P1.27-LS6.0-BL
U3: HCNR201; SMD-8_9.0MM
U5: BNC
U7: TMA0505D; TMA0505D_IL

Connections:
$2N1: R6.2, R7.1, U1.2
$2N2: RA1.2, U1.6
$2N3: R3.1, RA1.3
$2N4: R8.2, RA1.1
$2N5: R3.2, R6.1, TP2.1, U1.7
$2N6: R4.1, R7.2, TP4.1, U1.1
$2N7: RA2.2, TP3.1, U1.3
$2N9: C5.2, R4.2, U2.6, U3.3
$2N10: C5.1, TP5.1, U2.7, U3.1
$2N11: C1.1, R1.1, U3.6, U4.2
$2N12: C1.2, P2.3, R1.2, TP9.1, U4.1
$2N17: R2.2, U3.2
$2N21: R9.2, RA2.3
$2N24: R5.1, RA2.1
$2N52: U4.6, U4.7
$2N66: U2.1, U2.2
+5V: C4.1, C6.2, C9.2, R2.1, R5.2, TP6.1, U1.8, U2.8, U7.6
-5V: C3.2, C7.1, C8.1, TP7.1, U1.4, U2.4, U7.4
GND: C3.1, C4.2, C6.1, C7.2, C8.2, C9.1, R8.1, R9.1, TP1.1, U2.3, U2.5, U3.4, U5.GND, U7.5
VCC: C2.1, C10.1, P2.1, U4.8, U7.1
com: C2.2, C10.2, P2.2, TP8.1, U3.5, U4.3, U4.4, U4.5, U7.2
