igorlab/ph-leakage-tester/(commit log)

2026-10-29 Initial public snapshot
    [A_10M.csv, A_10M_run2.csv, A_10M_run3.csv, A_REF3040_bringup.csv, A_REF3040_leak.csv, A_REF3040_leak_2026-10-26.csv, A_REF3040_linearity_2026-10-26.csv, A_REF3040_linearity_2026-10-26_run2.csv]
2026-10-29 Wiring diagram: remove junction dots at plain bends
2026-10-29 Wiring diagram: invisible bend fix
2026-10-29 Wiring diagram: redrawn from a script, dots only at wire connections
2026-10-29 Wiring diagram fixes, neutral wording in script docstrings
    [fig_calibrator_schematic.py, make_paper_figures.py, make_photo_figures.py]
2026-10-29 Wiring diagram: ESP32-C3 and ADS1115 closer to the original
2026-11-10 Version 1.0 as archived on Zenodo (10.5281/zenodo.24111496): new data from 8-10 November, figures, firmware, enclosure files and the current HardwareX manuscript
    [A2_known_currents_2026-11-08_run7.csv, A2_known_currents_2026-11-08_run9.csv, H_hold_2026-11-09.csv, N_overnight_2026-11-09.csv, P_polarity_center_100mV_2026-11-09.csv, P_polarity_center_2026-11-09.csv, P_polarity_center_900s_2026-11-09.csv, P_polarity_shorted_100mV_2026-11-09.csv]
